naist-robotics/naist-openhand-m2s/README.md

# NAIST-Openhand-M2S

Contains all 3D printable parts for a version of the [Yale Openhand M2](https://www.eng.yale.edu/grablab/openhand/model_m2.html) including Optoforce 3D force sensors and bearings, and requiring no additional rubber surface manufacturing. The two degree of freedoms can be used for active perception and manipulation with tactile feedback.

See the demo video [here](https://youtu.be/vZjTQ-7LhDY).

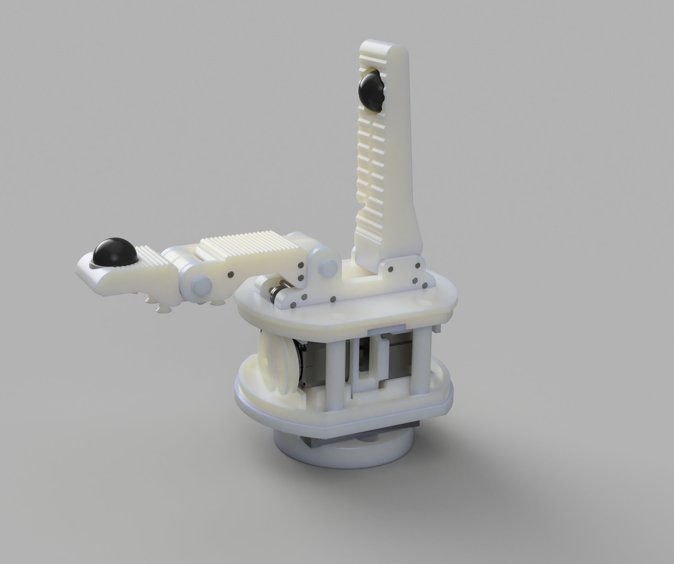
[picture p1: render.jpg]


Refer to the [Finger Fabrication Guide](https://www.eng.yale.edu/grablab/openhand/model%20m2/Fabrication%20-%20Model%20M2%201.0.pdf) of the Yale Openhand M2 for details on the assembly.

This hand is driven by wire. We used fishing line made of Dyneema.　Refer to the [manual(p.15)](https://www.eng.yale.edu/grablab/openhand/model%20m2/Fabrication%20-%20Model%20M2%201.0.pdf) for the position of the wire.

The base uses Dynamixel MX-28AT motors or HiTEC HS5585 servo motors. An Arduino controller case that can be attached to the base is included in the STL files.
