naist-robotics/naist-openhand-m2s/body-dynamixel/STEP/MX28_spacer.stp

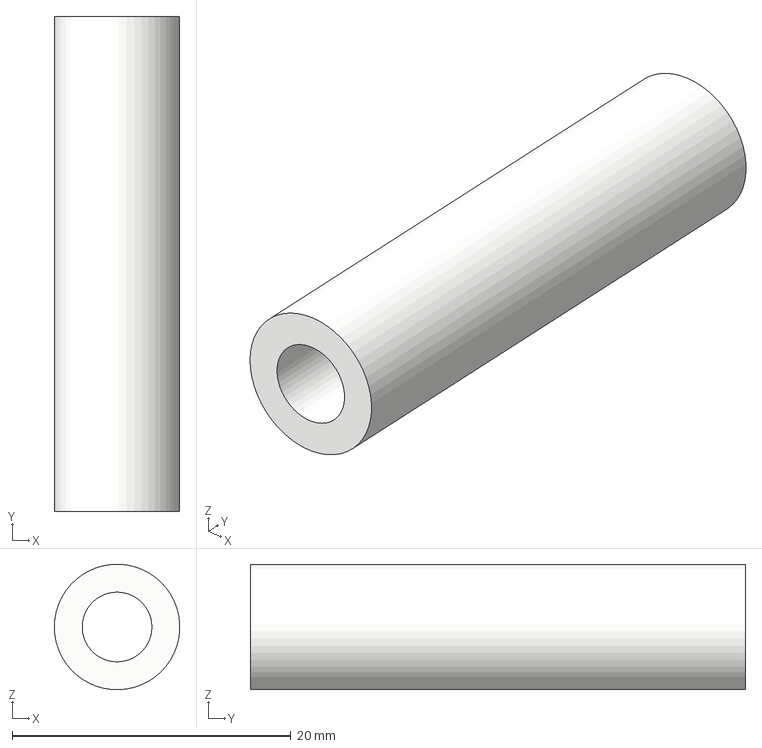
[picture p2: CAD file, 2017-09-04]
body-dynamixel/STEP/MX28_spacer.stp
8.99 x 35.5 x 9.00 mm
