naist-robotics/naist-openhand-m2s/body-HITEC/STEP/bottom_base_HiTEC.stp

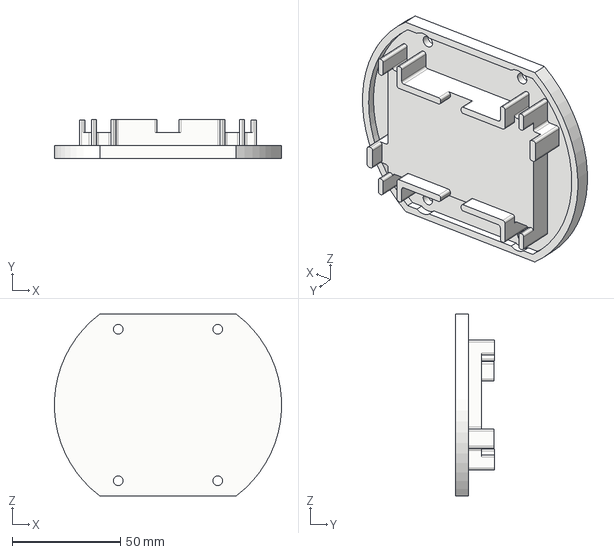
[picture p3: CAD file, 2017-09-04]
body-HITEC/STEP/bottom_base_HiTEC.stp
104.9 x 18.0 x 84.0 mm
