naist-robotics/naist-openhand-m2s/hand/STEP/m2hand_fingertip.stp

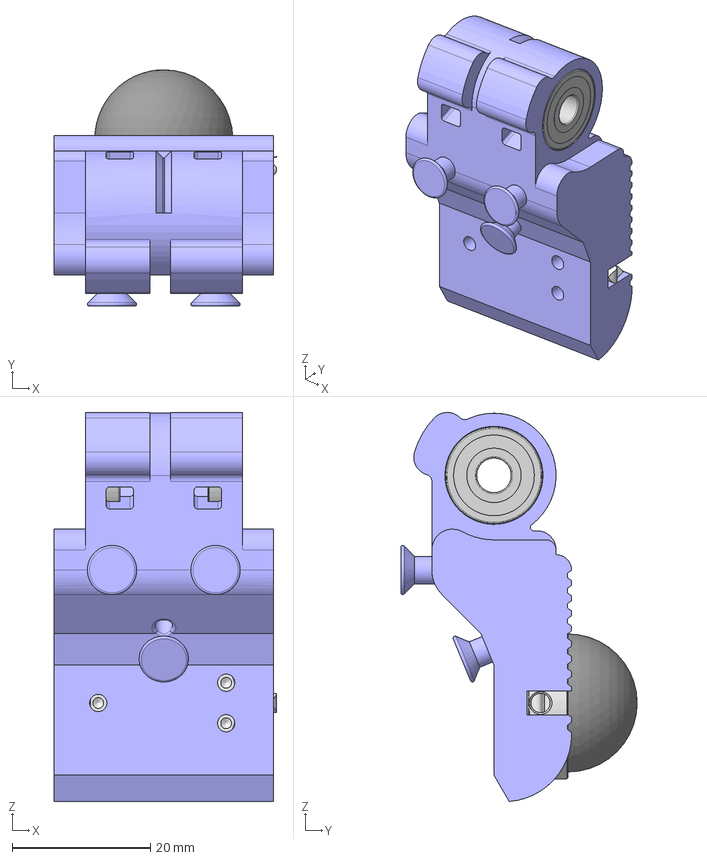
[picture p4: CAD file, 2017-09-13]
hand/STEP/m2hand_fingertip.stp
32.2 x 34.3 x 56.4 mm
Tip finger
STV1
StraightCable
D20_dome_black
_605ZZ Inner ring x 2
_605ZZ Outer ring x 2
_605ZZ Shield x 4
_605ZZ Ball x 12
