naist-robotics/naist-openhand-m2s/body-dynamixel/STEP/MX-28.stp

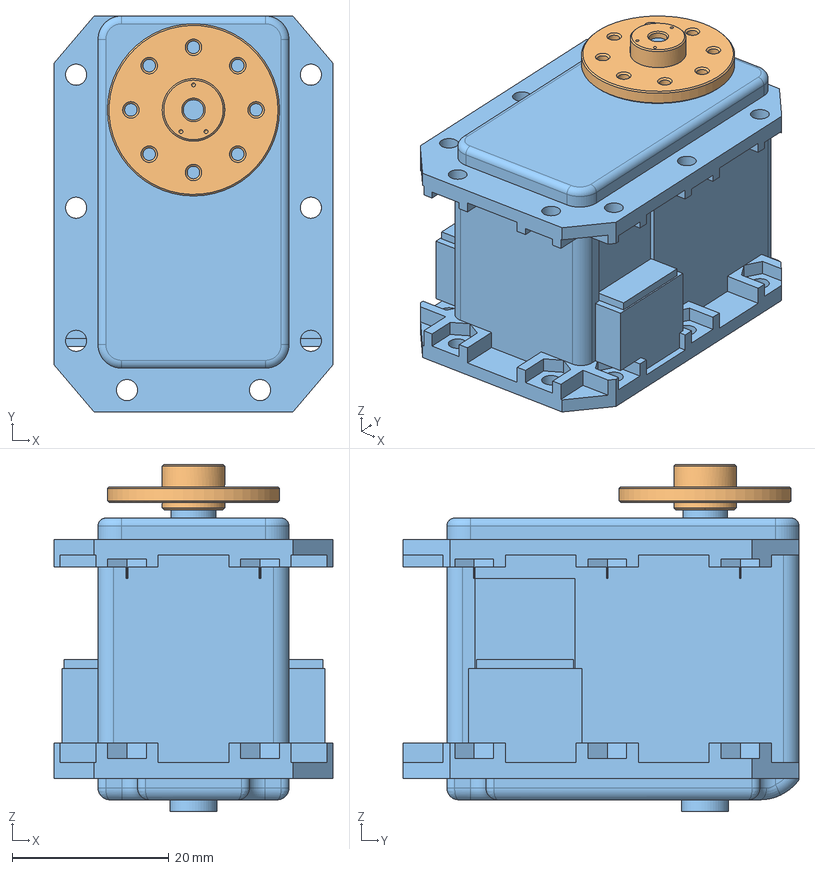
[picture p5: CAD file, 2017-09-04]
body-dynamixel/STEP/MX-28.stp
35.6 x 50.6 x 44.4 mm
HN07-N101 v1
