naist-robotics/naist-openhand-m2s/body-HITEC/STEP/HS5585.stp

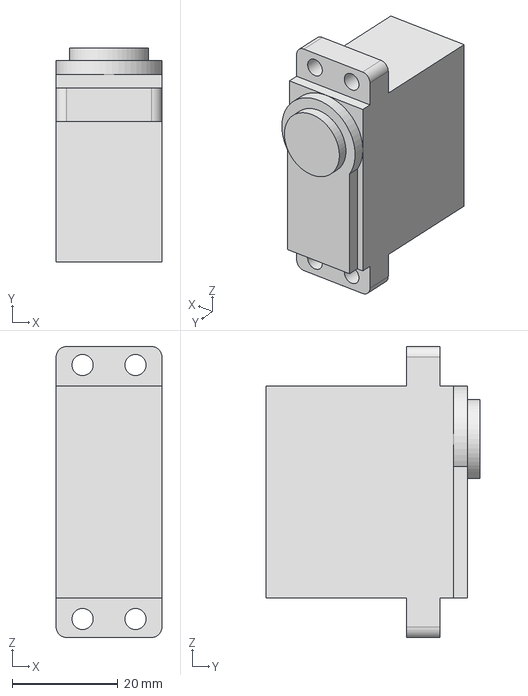
[picture p6: CAD file, 2017-09-04]
body-HITEC/STEP/HS5585.stp
20.0 x 40.4 x 55.0 mm
