naist-robotics/naist-openhand-m2s/hand/STEP/m2hand_CPlink.stp

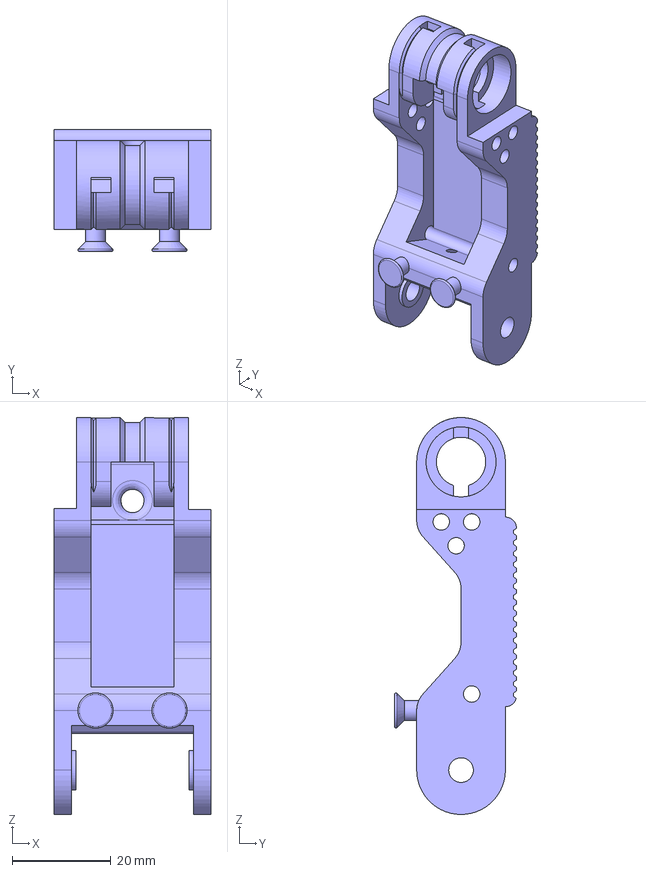
[picture p7: CAD file, 2017-09-13]
hand/STEP/m2hand_CPlink.stp
31.8 x 24.8 x 80.5 mm
