naist-robotics/naist-openhand-m2s/body-dynamixel/STEP/MX28_cover.stp

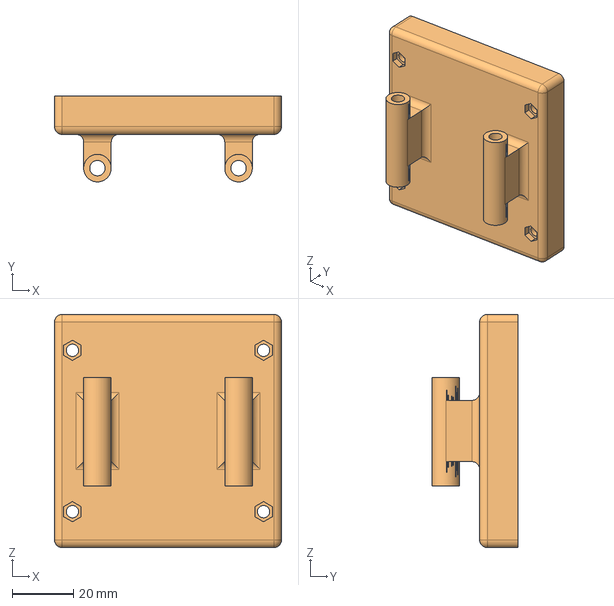
[picture p8: CAD file, 2017-09-04]
body-dynamixel/STEP/MX28_cover.stp
74.0 x 28.0 x 76.0 mm
MX28_spacer v3 x 2
