naist-robotics/naist-openhand-m2s/body-HITEC/STEP/servo_part.stp

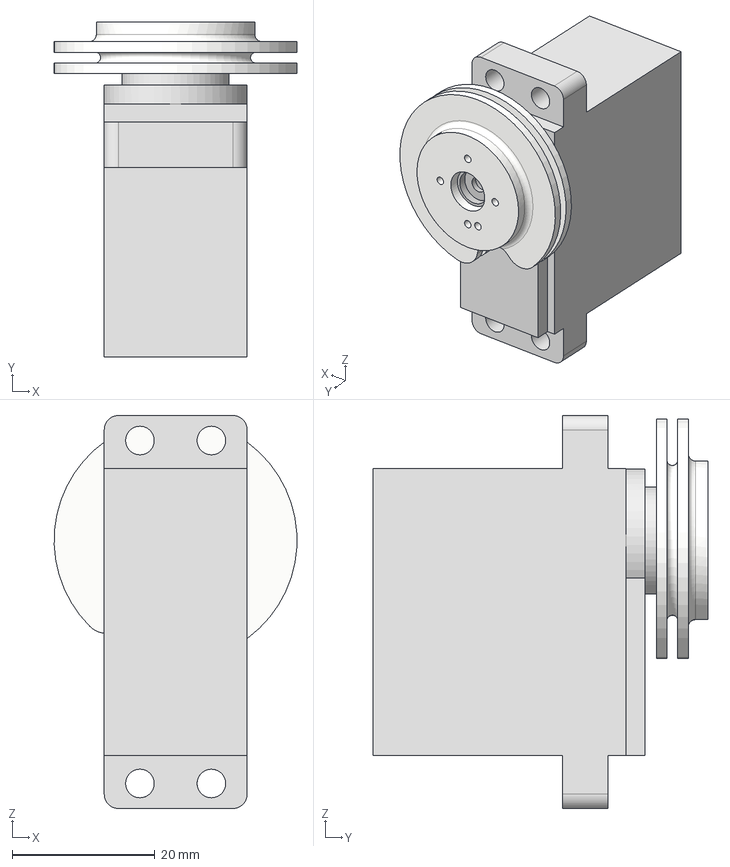
[picture p9: CAD file, 2017-09-04]
body-HITEC/STEP/servo_part.stp
34.0 x 46.9 x 55.0 mm
HS5585 v5
HiTEC_servo_horn v4
new_horn_HiTEC v17
