naist-robotics/naist-openhand-m2s/hand/STEP/pulley_v2_small.stp

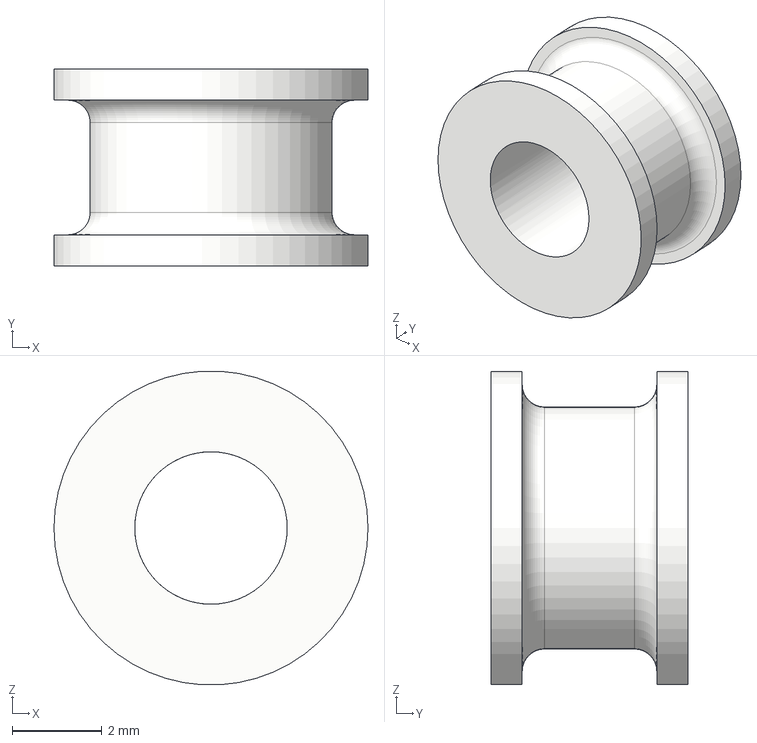
[picture p10: CAD file, 2017-09-13]
hand/STEP/pulley_v2_small.stp
7.00 x 4.40 x 6.99 mm
