naist-robotics/naist-openhand-m2s/body-dynamixel/STEP/MX-28hone.stp

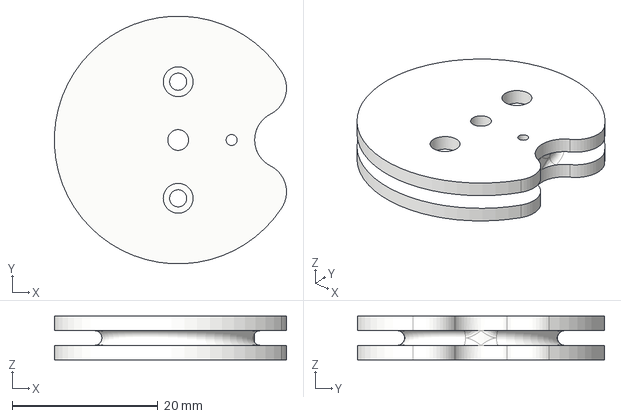
[picture p11: CAD file, 2017-09-04]
body-dynamixel/STEP/MX-28hone.stp
31.8 x 34.0 x 6.00 mm
