naist-robotics/naist-openhand-m2s/body-HITEC/STEP/HN07-N101.stp

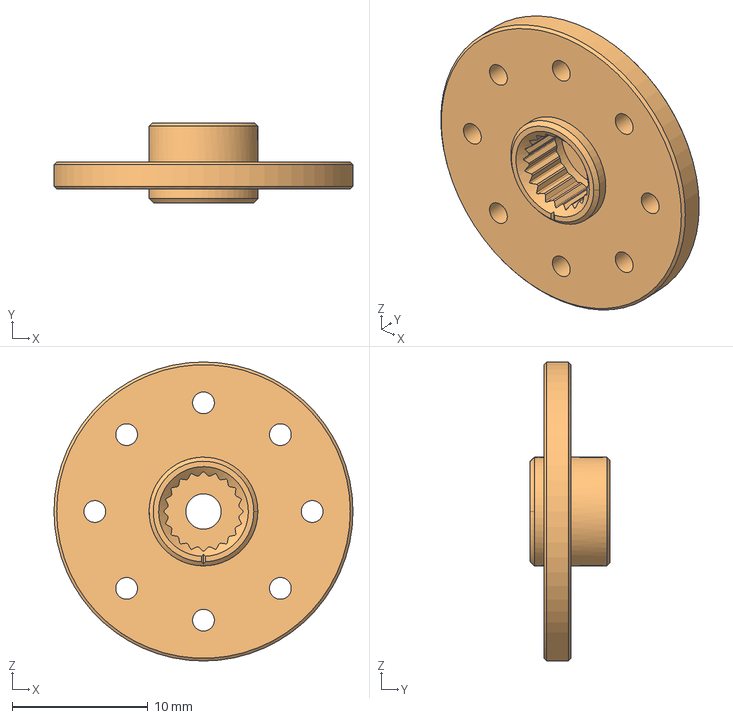
[picture p12: CAD file, 2017-09-04]
body-HITEC/STEP/HN07-N101.stp
22.0 x 5.85 x 22.0 mm
