naist-robotics/naist-openhand-m2s/hand/STEP/OMD-20-Sx-CAD.stp

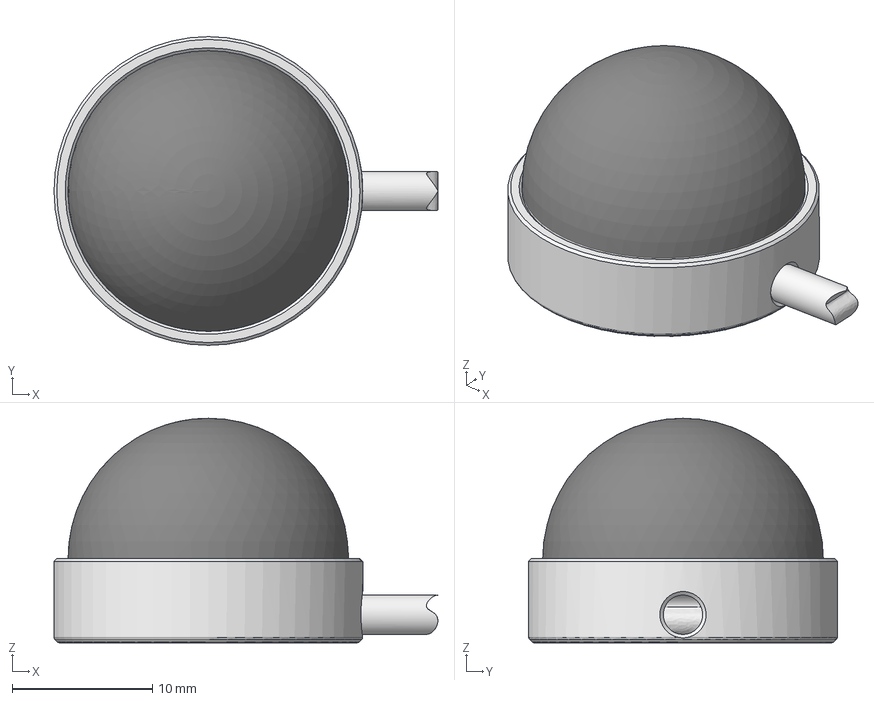
[picture p13: CAD file, 2017-09-04]
hand/STEP/OMD-20-Sx-CAD.stp
27.4 x 22.0 x 16.0 mm
