naist-robotics/naist-openhand-m2s/body-dynamixel/STEP/MX28_bottom_base.stp

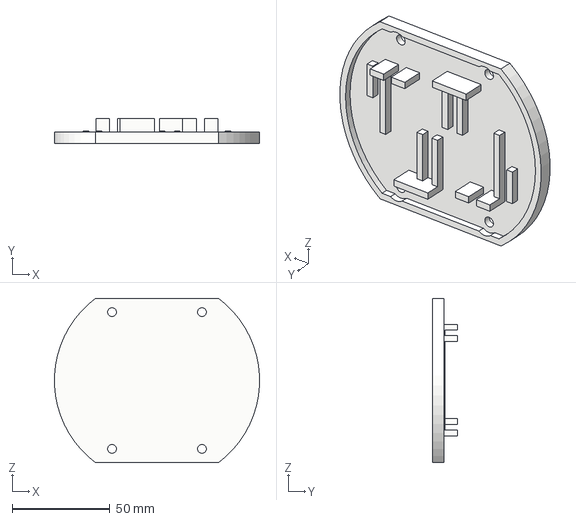
[picture p14: CAD file, 2017-09-04]
body-dynamixel/STEP/MX28_bottom_base.stp
104.9 x 13.0 x 84.0 mm
a3_t42 v5
