naist-robotics/naist-openhand-m2s/body-HITEC/STEP/HiTEC_regular_servo_horn.stp

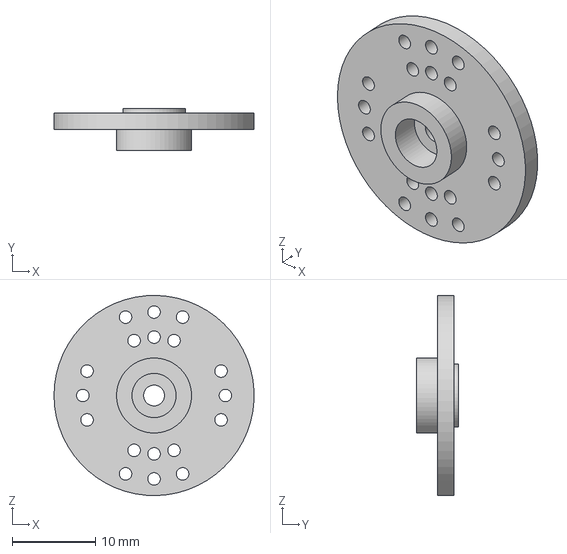
[picture p15: CAD file, 2017-09-04]
body-HITEC/STEP/HiTEC_regular_servo_horn.stp
24.0 x 5.00 x 24.0 mm
