naist-robotics/naist-openhand-m2s/hand/STEP/base_cover.stp

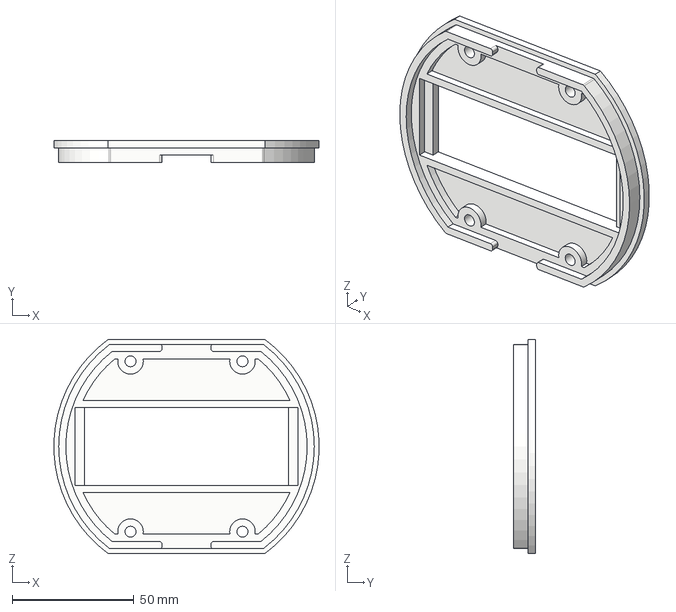
[picture p16: CAD file, 2017-09-04]
hand/STEP/base_cover.stp
108.9 x 9.00 x 88.0 mm
