naist-robotics/naist-openhand-m2s/body-dynamixel/STEP/MX-28hone_cover.stp

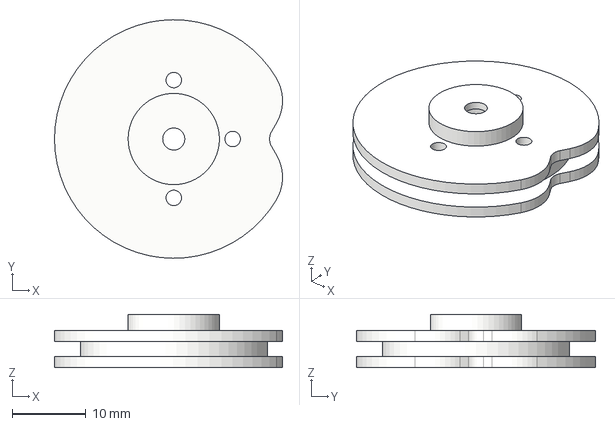
[picture p17: CAD file, 2017-09-04]
body-dynamixel/STEP/MX-28hone_cover.stp
31.0 x 32.4 x 7.20 mm
