naist-robotics/naist-openhand-m2s/hand/STEP/puley_ver2.stp

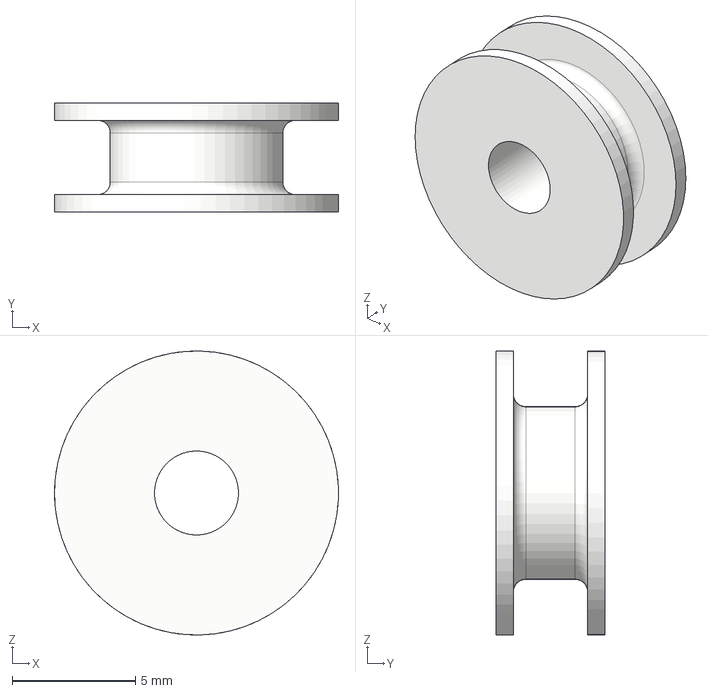
[picture p19: CAD file, 2017-09-04]
hand/STEP/puley_ver2.stp
11.5 x 4.40 x 11.5 mm
