naist-robotics/naist-openhand-m2s/body-dynamixel/STEP/gear_wheel.stp

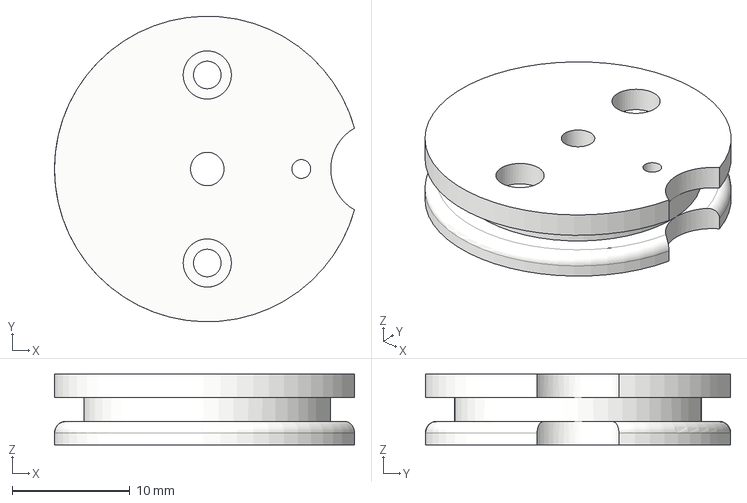
[picture p20: CAD file, 2017-09-04]
body-dynamixel/STEP/gear_wheel.stp
25.5 x 26.0 x 6.00 mm
