naist-robotics/naist-openhand-m2s/hand/STEP/thumb_part.stp

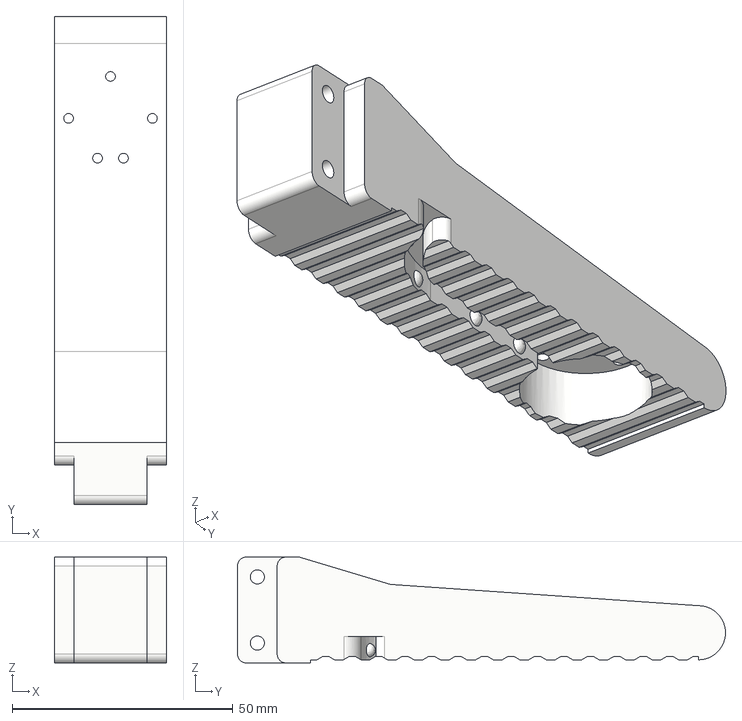
[picture p22: CAD file, 2017-09-04]
hand/STEP/thumb_part.stp
25.5 x 110.6 x 24.0 mm
