naist-robotics/naist-openhand-m2s/body-dynamixel/STEP/MX28_topbase.stp

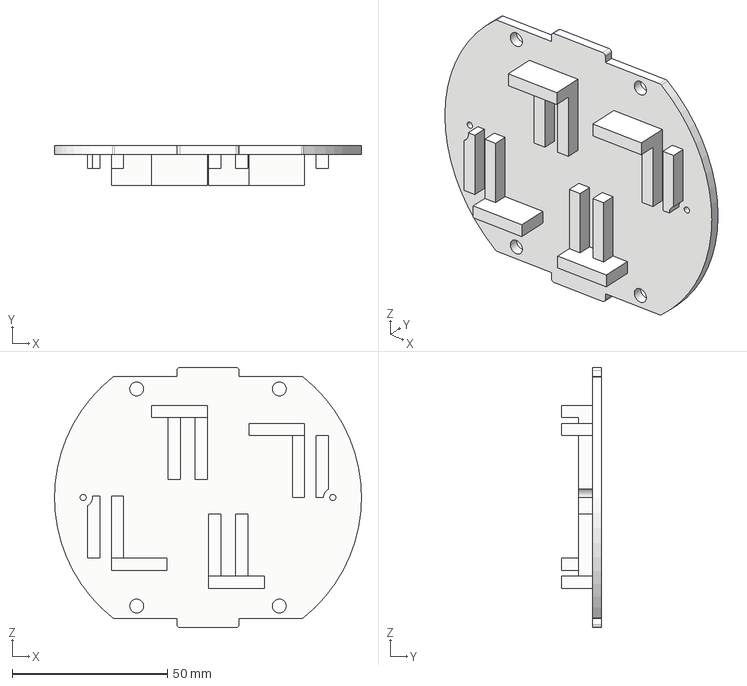
[picture p23: CAD file, 2017-09-04]
body-dynamixel/STEP/MX28_topbase.stp
99.0 x 13.0 x 84.0 mm
