naist-robotics/naist-openhand-m2s/body-HITEC/STEP/new_horn_HiTEC.stp

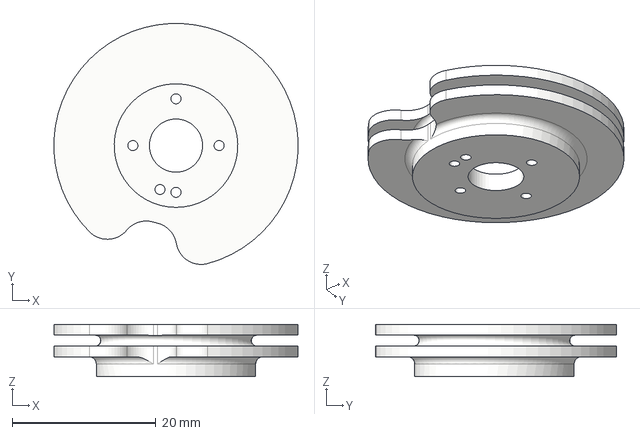
[picture p24: CAD file, 2017-09-04]
body-HITEC/STEP/new_horn_HiTEC.stp
34.0 x 33.5 x 7.25 mm
