naist-robotics/naist-openhand-m2s/hand/STEP/bearing.stp

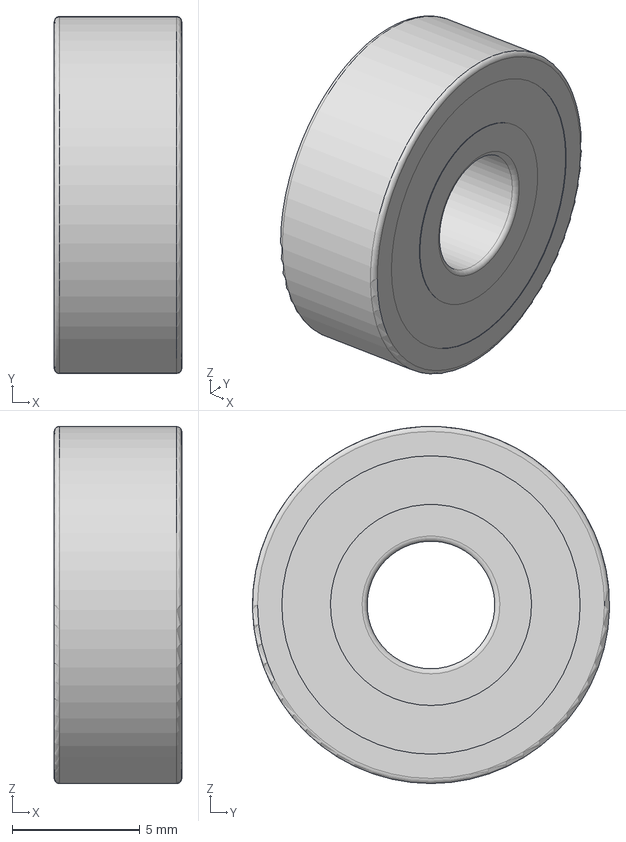
[picture p25: CAD file, 2017-09-04]
hand/STEP/bearing.stp
5.00 x 14.0 x 14.0 mm
_605ZZ Inner ring
_605ZZ Outer ring
_605ZZ Shield x 2
_605ZZ Ball x 6
