naist-robotics/naist-openhand-m2s/body-dynamixel/STEP/MX28_motorpart.stp

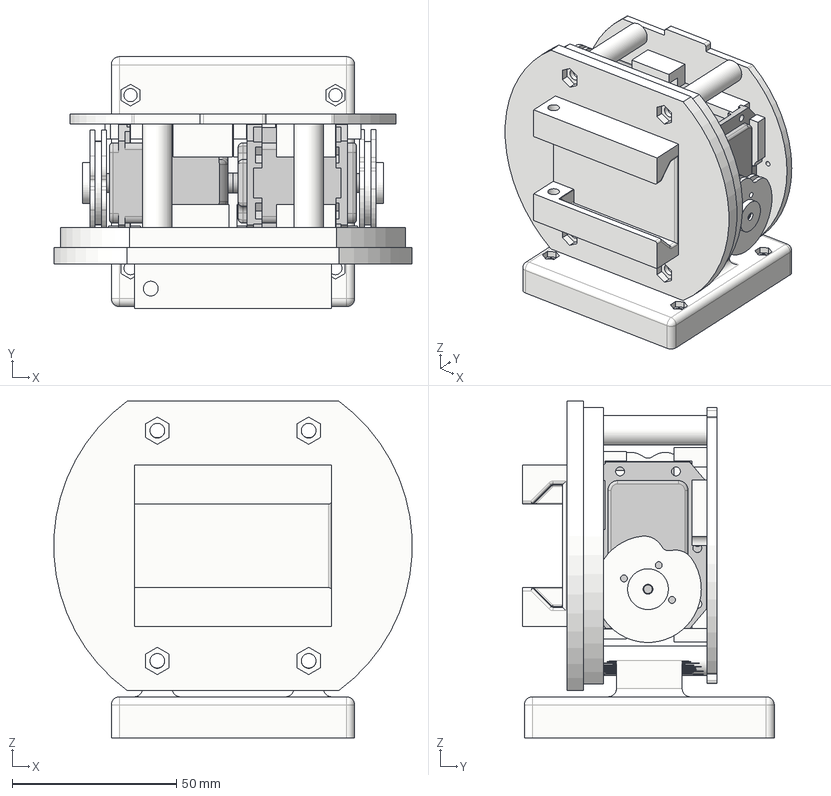
[picture p26: CAD file, 2017-09-04]
body-dynamixel/STEP/MX28_motorpart.stp
108.8 x 76.5 x 102.4 mm
MX28_spacer v3 x 4
a3_t42 v5
HN07-N101 v1 x 2
dovetail_female v1
MX-28hone_cover v8
MX-28hone_cover v8_1
