naist-robotics/naist-openhand-m2s/body-HITEC/STEP/HiTEC_servo_horn.stp

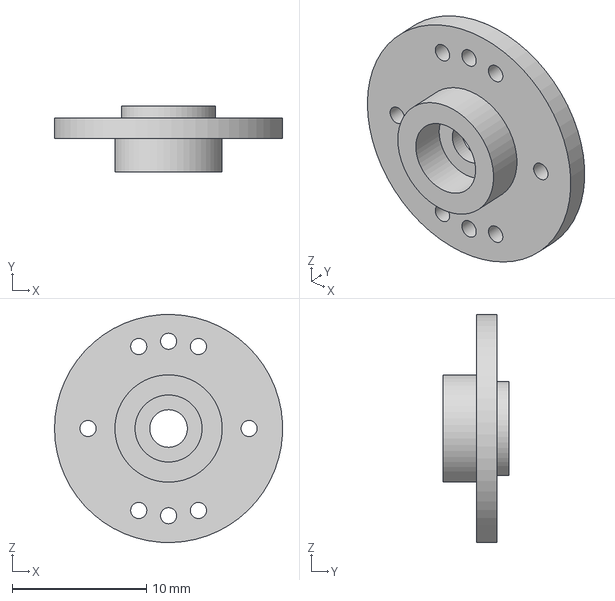
[picture p27: CAD file, 2017-09-04]
body-HITEC/STEP/HiTEC_servo_horn.stp
17.0 x 4.90 x 17.0 mm
