naist-robotics/naist-openhand-m2s/body-HITEC/STEP/top_base_HiTEC.stp

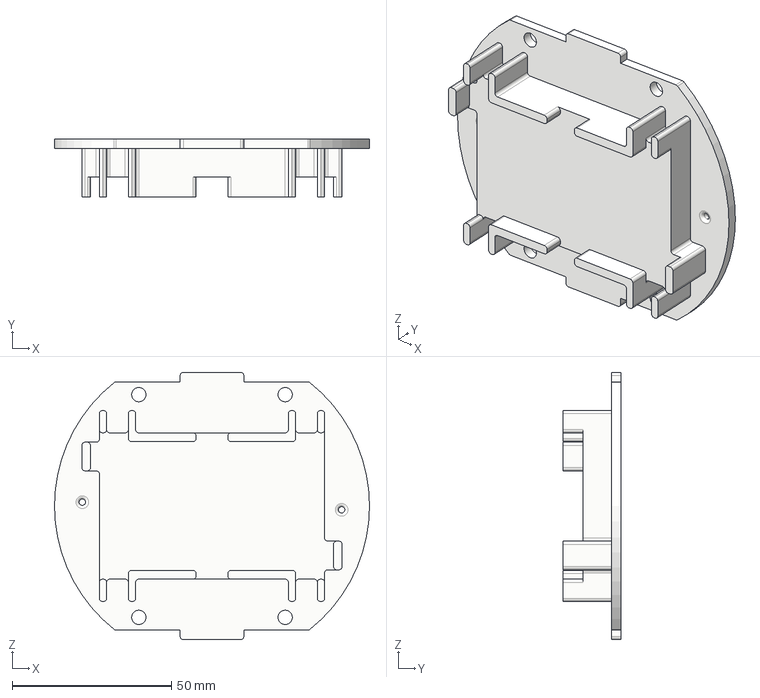
[picture p29: CAD file, 2017-09-04]
body-HITEC/STEP/top_base_HiTEC.stp
99.0 x 18.2 x 84.0 mm
