naist-robotics/naist-openhand-m2s/hand/STEP/stick.stp

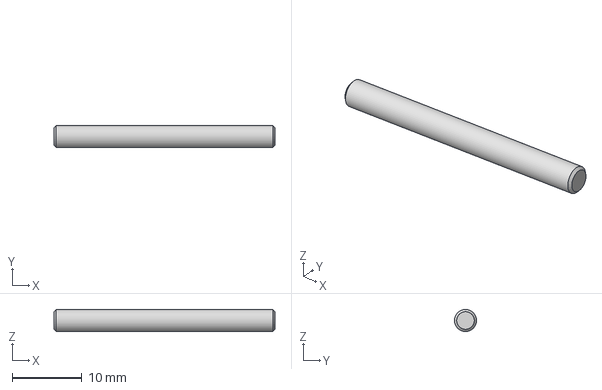
[picture p30: CAD file, 2017-09-04]
hand/STEP/stick.stp
31.8 x 3.17 x 3.17 mm
