naist-robotics/naist-openhand-m2s/body-HITEC/STEP/HITEC_spacer.stp

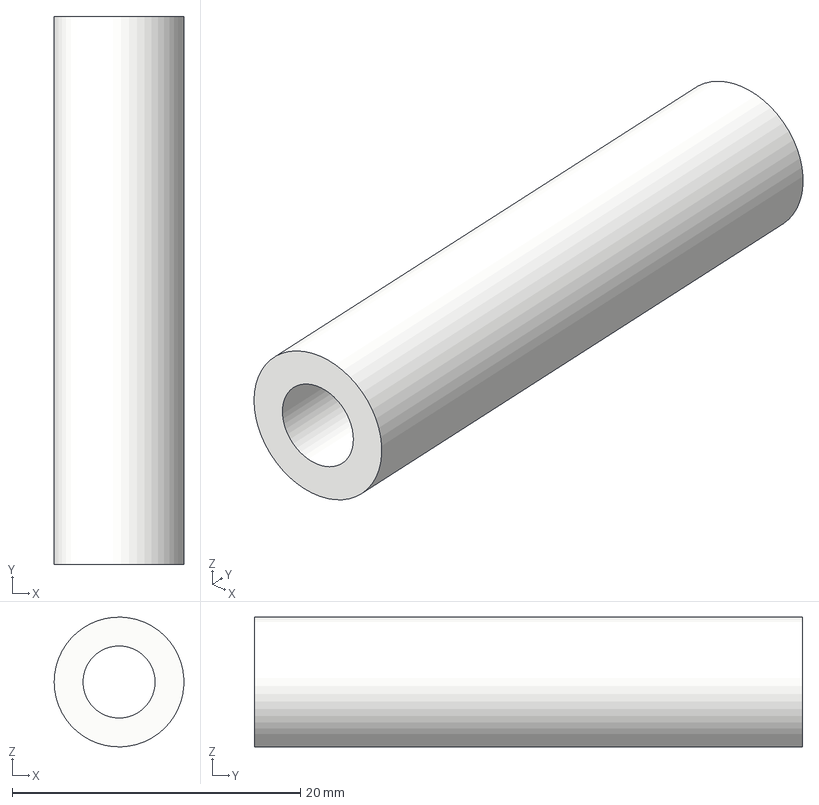
[picture p31: CAD file, 2017-09-04]
body-HITEC/STEP/HITEC_spacer.stp
8.99 x 38.0 x 9.00 mm
