naist-robotics/naist-openhand-m2s/hand/STEP/top_cover.stp

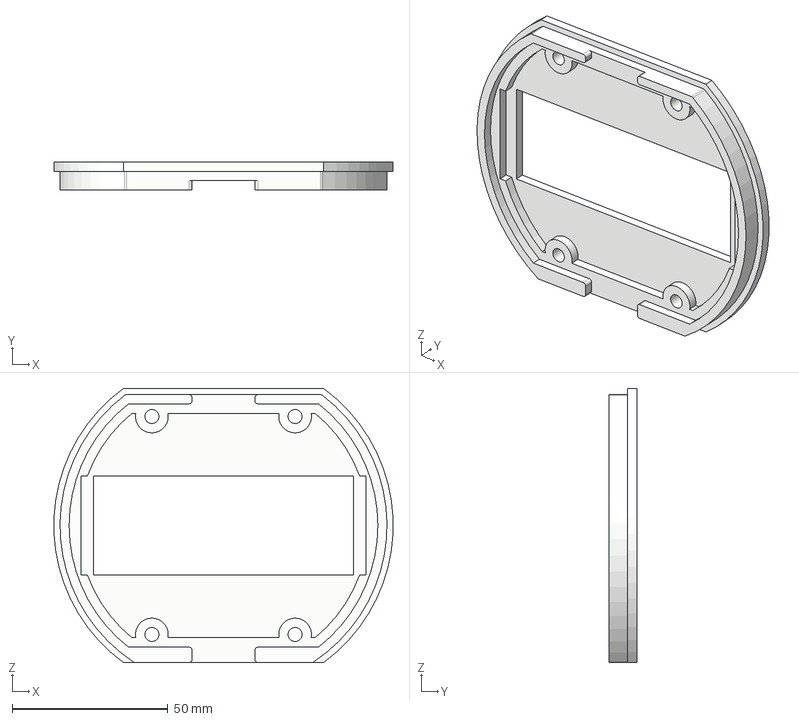
[picture p33: CAD file, 2017-09-04]
hand/STEP/top_cover.stp
108.9 x 9.00 x 88.0 mm
