naist-robotics/naist-openhand-m2s/hand/STEP/finger_axis.stp

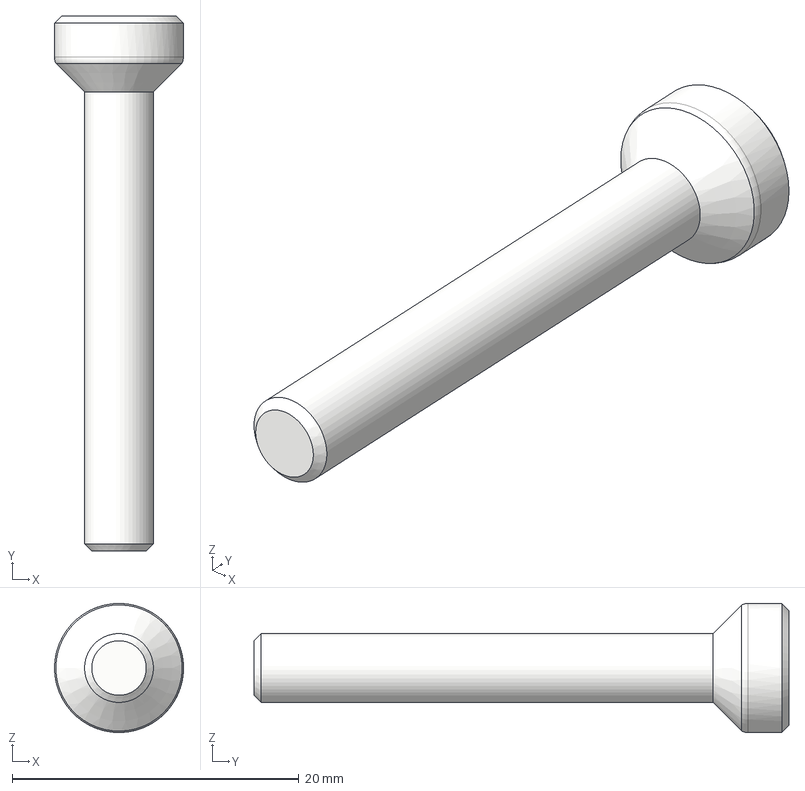
[picture p34: CAD file, 2017-09-04]
hand/STEP/finger_axis.stp
9.00 x 37.3 x 9.00 mm
