naist-robotics/naist-openhand-m2s/hand/STEP/metal_axis.stp

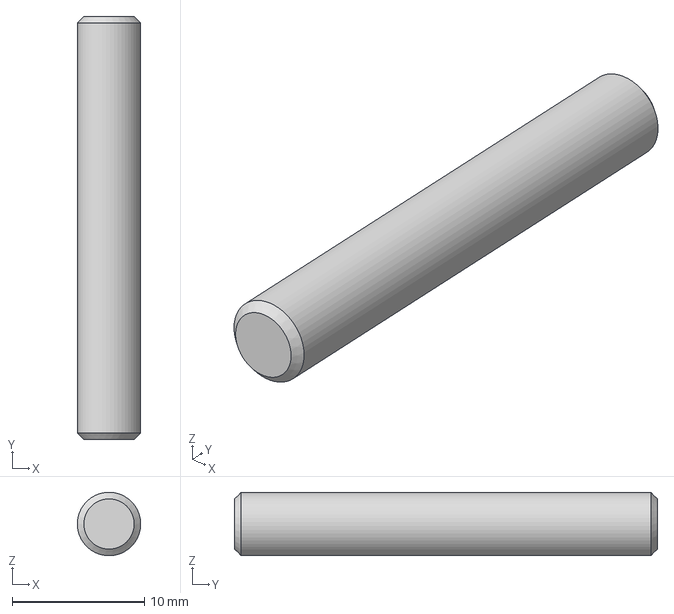
[picture p35: CAD file, 2017-09-04]
hand/STEP/metal_axis.stp
4.80 x 32.0 x 4.80 mm
