naist-robotics/naist-openhand-m2s/(list of files, cad)

Other CAD files:
body-HITEC/STL/HITEC_spacer.stl
body-HITEC/STL/HN07-N101.stl
body-HITEC/STL/HS5585.stl
body-HITEC/STL/HiTEC_regular_servo_horn.stl
body-HITEC/STL/HiTEC_servo_horn.stl
body-HITEC/STL/bottom_base_HiTEC.stl
body-HITEC/STL/hand_parts.stl
body-HITEC/STL/new_horn_HiTEC.stl
body-HITEC/STL/servo_part.stl
body-HITEC/STL/top_base_HiTEC.stl
body-dynamixel/STL/MX-28.stl
body-dynamixel/STL/MX-28hone.stl
body-dynamixel/STL/MX-28hone_cover.stl
body-dynamixel/STL/MX28_bottom_base.stl
body-dynamixel/STL/MX28_cover.stl
body-dynamixel/STL/MX28_motorpart.stl
body-dynamixel/STL/MX28_spacer.stl
body-dynamixel/STL/MX28_topbase.stl
body-dynamixel/STL/gear_wheel.stl
hand/STL/OMD-20-Sx-CAD.stl
hand/STL/base_cover.stl
hand/STL/base_parts.stl
hand/STL/bearing.stl
hand/STL/finger_axis.stl
hand/STL/hand_parts.stl
hand/STL/m2hand_CPlink.stl
hand/STL/m2hand_fingertip.stl
hand/STL/metal_axis.stl
hand/STL/puley_ver2.stl
hand/STL/pulley_v2_small.stl
hand/STL/stick.stl
hand/STL/thumb_part.stl
hand/STL/top_cover.stl
