naist-robotics/naist-openhand-m2s/(commit log)

2017-01-31 Removed extra folder
    [3d_sensor.stl, base finger.stl, base_cover.stl, base_part.stl, bearing.stl, finger_axis.stl, stick.stl, thumb_part.stl]
2017-02-06 Deleted hand folder
    [base_cover.stl, base_part.stl, bearing.stl, finger_axis.stl, stick.stl, thumb_part.stl, tip finger.stl]
2017-02-06 Update hand folder
    [3d_optoforce_sensor.stl, Pivot-Pivot_finger_distal_link.stl, Pivot-Pivot_finger_proximal_link.stl, a1_m.stl, bearing.stl, c1_m2.stl, finger_axis.stl, nylon_pulley.stl]
2017-02-06 Change name
    file name change
    [a2_dynamixel_m2.stl, a3_dynamixel_m2.stl, a4_coupling_m.stl, b1_dynamixel_m.stl, controlcase.stl]
2017-08-22 Update & add hitec servo base
    [HITEC_spacer.stl, HN07-N101.stl, HS5585.stl, HiTEC_regular_servo_horn.stl, HiTEC_servo_horn.stl, MX-28.stl, MX-28hone.stl, MX-28hone_cover.stl]
2017-09-04 Add STEP files, add latest top part
    [3d_optoforce_sensor.stl, CICP_hand_ver.stp, HITEC_spacer.stl, HITEC_spacer.stp, HN07-N101.stl, HN07-N101.stp, HS5585.stl, HS5585.stp]
2017-09-13 Add small pulley and corrected thumb parts
    The thumb parts were missing cuts for the bearings
    [hand_m2 v1_finger_pp_m2_A.stl, hand_m2 v1_finger_pp_m2_A.stp, m2hand_complete.stl, m2hand_complete.stp, m2hand_fingertip.stl, m2hand_fingertip.stp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]
